chargedhex/magnetic-encoder-sao-supercon-2026/3d-prints/Supercon 2026 Encoder SAO 3D Prints-Knob Base.step

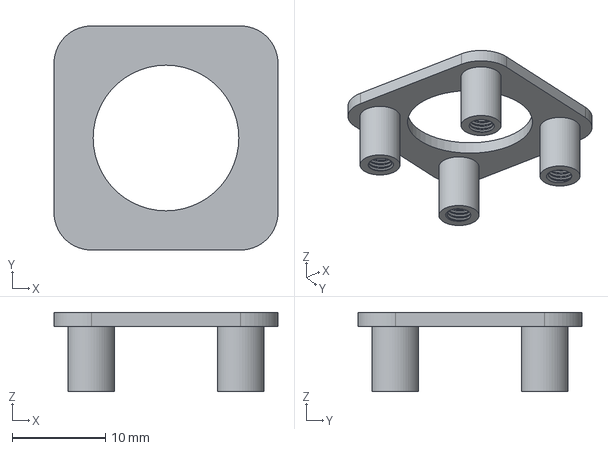
[picture p1: CAD file, 2026-11-10]
3d-prints/Supercon 2026 Encoder SAO 3D Prints-Knob Base.step
24.0 x 24.0 x 8.50 mm
