chargedhex/magnetic-encoder-sao-supercon-2026/3d-prints/Supercon 2026 Encoder SAO 3D Prints-Knob Top.step

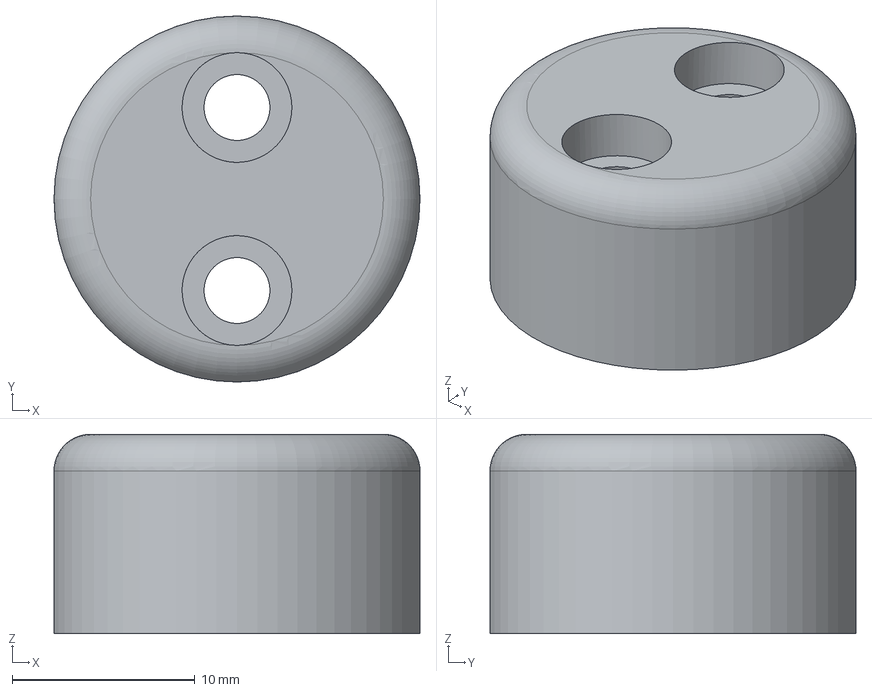
[picture p2: CAD file, 2026-11-10]
3d-prints/Supercon 2026 Encoder SAO 3D Prints-Knob Top.step
20.0 x 20.0 x 10.9 mm
