chargedhex/magnetic-encoder-sao-supercon-2026/3d-prints/Supercon 2026 Encoder SAO 3D Prints-Knob Base 3.step

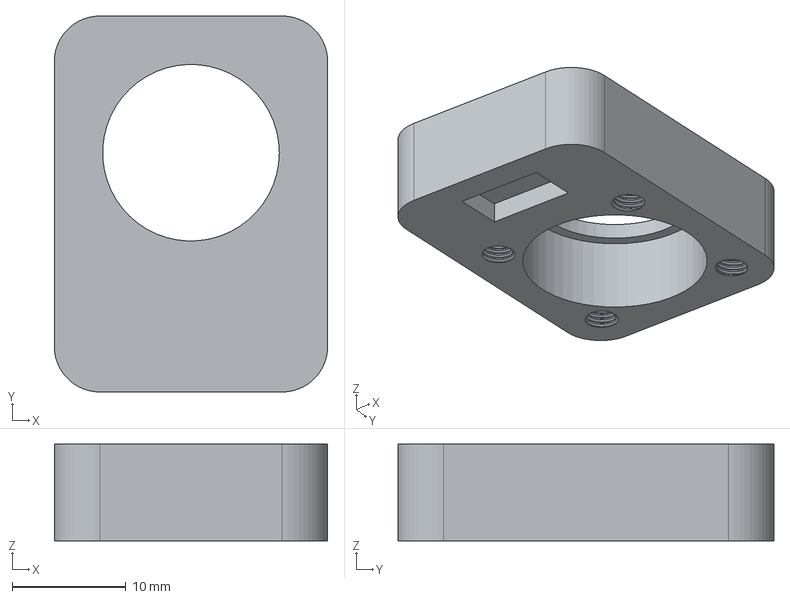
[picture p3: CAD file, 2026-11-10]
3d-prints/Supercon 2026 Encoder SAO 3D Prints-Knob Base 3.step
24.0 x 33.0 x 8.50 mm
