chargedhex/magnetic-encoder-sao-supercon-2026/3d-prints/Supercon 2026 Encoder SAO 3D Prints-Knob Top 2.step

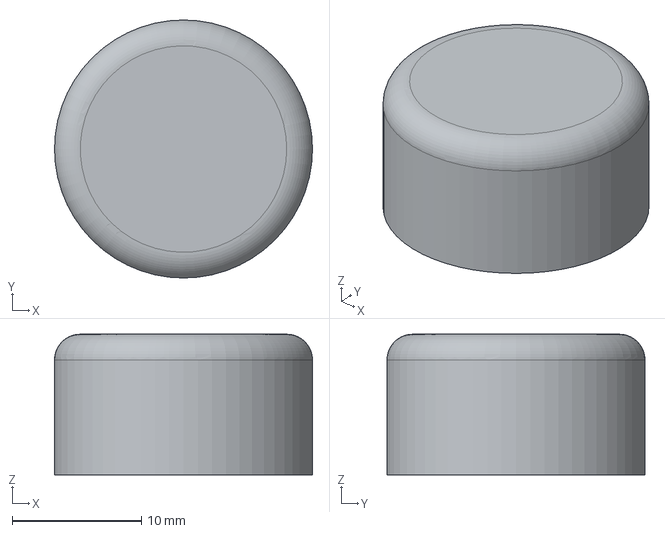
[picture p5: CAD file, 2026-11-10]
3d-prints/Supercon 2026 Encoder SAO 3D Prints-Knob Top 2.step
20.0 x 20.0 x 10.9 mm
