chargedhex/magnetic-encoder-sao-supercon-2026/3d-prints/Supercon 2026 Encoder SAO 3D Prints.FCStd

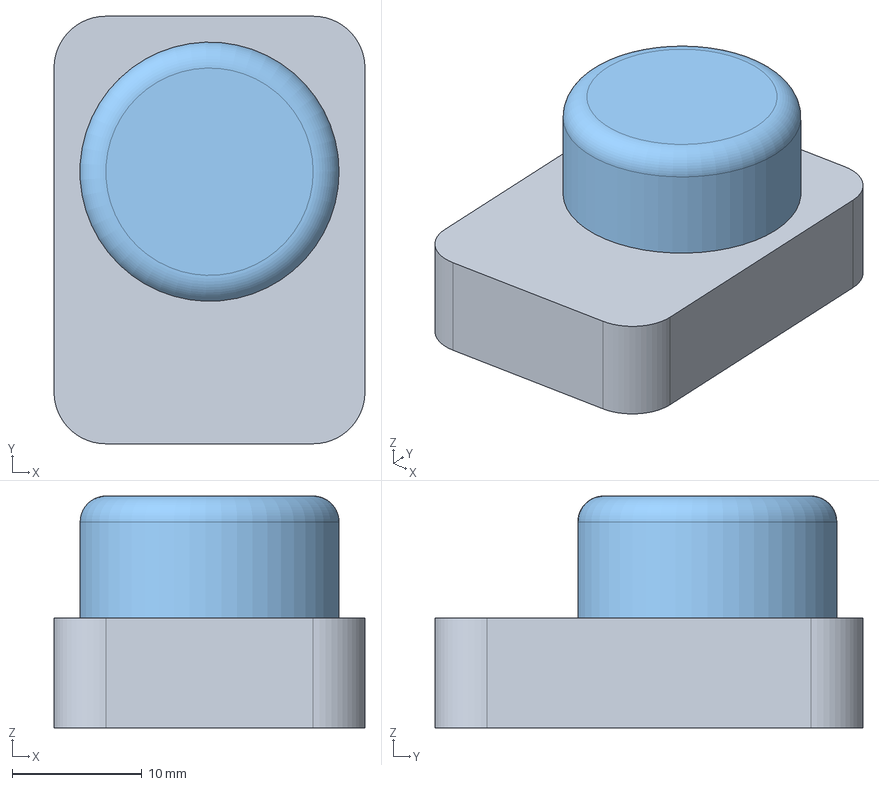
[picture p8: CAD file, 2026-11-06]
3d-prints/Supercon 2026 Encoder SAO 3D Prints.FCStd
24.0 x 33.0 x 17.9 mm
Knob Base 3
Knob Shaft 2
Knob Top 2
