chargedhex/magnetic-encoder-sao-supercon-2026/hardware/encoder_sao_connector_supercon_2026.kicad_pcb

## KiCad design hardware/encoder_sao_connector_supercon_2026.kicad_pcb (2026-11-06)

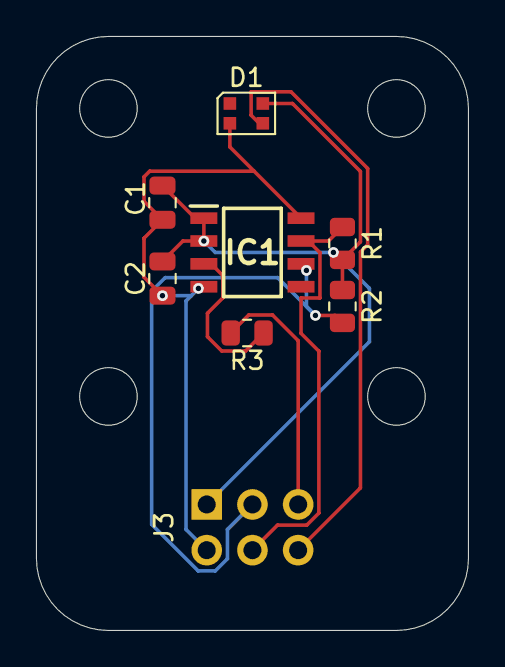
[picture p9: board encoder_sao_connector_supercon_2026.kicad_pcb from above]

Board: 2 copper layers, 24.0 x 33.0 mm, 8 parts (1 on the bottom side), 7 nets.

Parts:
C1: 100nF; C_0805_2012Metric
C2: 1uF; C_0805_2012Metric
D1: WS2812B-2020; LED_WS2812B-2020_PLCC4_2.0x2.0mm
IC1: AS5600-ASOT
J3: Conn_02x03_Odd_Even; PinHeader_2x03_P2.54mm_Vertical
R1, R2: 4.7k; R_0805_2012Metric
R3: 330; R_0805_2012Metric

Connections:
+3V3: C1.1, C2.1, D1.4 (VDD), IC1.1 (VDD5V), IC1.2 (VDD3V3), J3.1, R1.2, R2.1
GND: C1.2, C2.2, D1.2 (VSS), IC1.4 (GND), IC1.8 (DIR), J3.2
encoder_analog_out: IC1.3 (OUT), R3.2
encoder_i2c_scl: IC1.7 (SCL), J3.4, R1.1
encoder_i2c_sda: IC1.6 (SDA), J3.3, R2.2
neopixel_data: D1.3 (DIN), J3.6
resistor_analog_out: J3.5, R3.1
