chargedhex/magnetic-encoder-sao-supercon-2026/3d-prints/README.md

# Magnetic Encoder 3D Files
These 3d prints are required for the magnetic encoder to have something to read. There are a few different types of base, shaft, and top. All the bases are compatible with all of the shaft and top types, but the knob shaft and knob top types need to match. Knob Top is only compatible with Knob Shaft, and Knob Top 2 is only compatible with Knob Shaft 2, but Knob Base, Knob Base 2, and Knob Base 3 are compatible with both sets of tops and shafts.

I have included the .FDStd file (open with FreeCAD to edit) where they are all instantiated. For ease of 3d printing, I have also provided all the components as individual .step files.

Knob Shaft 2 is shaped as it is to make support removal a bit easier for 3d printing, but wave overhangs also work well with its current geometry.

## Knob Base
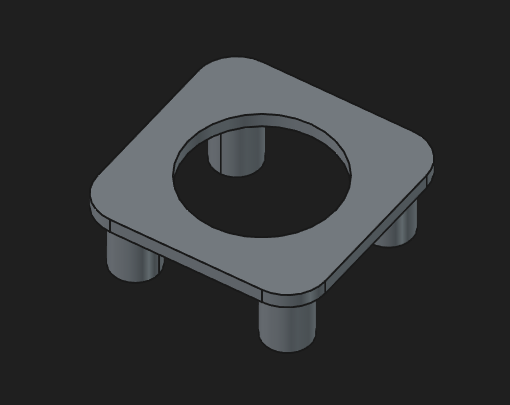
[picture p10: 3d-prints/images/Knob_Base.png]
Knob_Base Knob Base Photo


## Knob Base 2
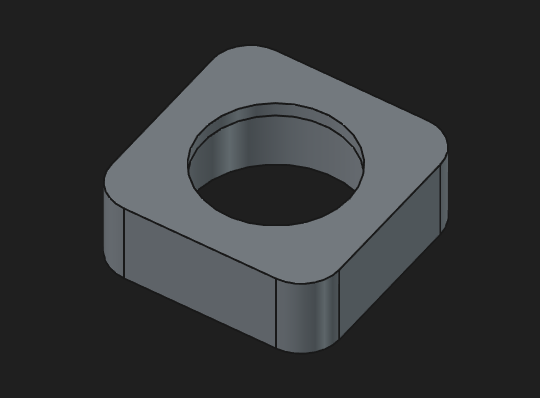
[picture p11: 3d-prints/images/Knob_Base_2.png]
Knob_Base_2 Knob Base 2 Photo


## Knob Base 3
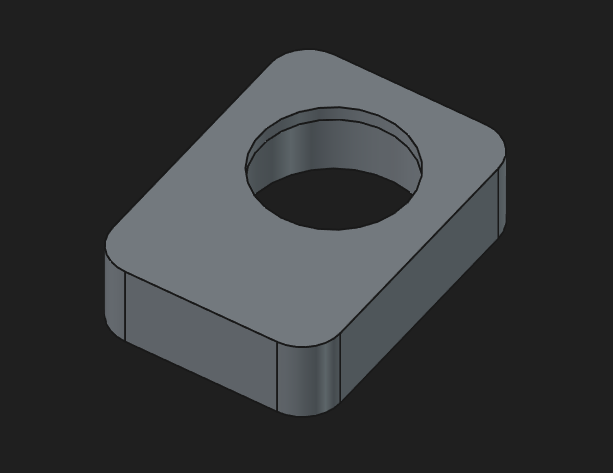
[picture p12: 3d-prints/images/Knob_Base_3.png]
Knob_Base_3 Knob Base 3 Photo


## Knob Top
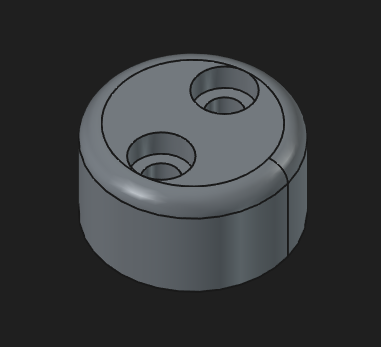
[picture p13: 3d-prints/images/Knob_Top.png]
Knob_Top Knob Top Photo


## Knob Shaft
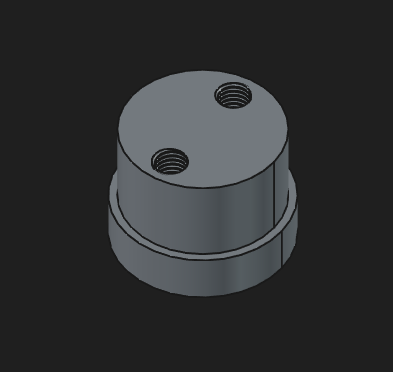
[picture p14: 3d-prints/images/Knob_Shaft.png]
Knob_Shaft Knob Shaft Photo


## Knob Top 2
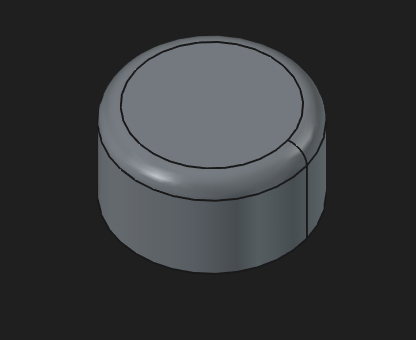
[picture p15: 3d-prints/images/Knob_Top_2.png]
Knob_Top_2 Knob Top 2 Photo


## Knob Shaft 2
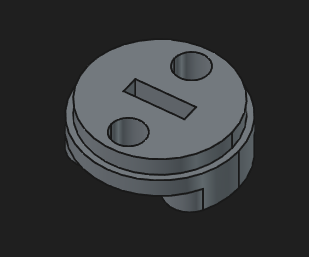
[picture p16: 3d-prints/images/Knob_Shaft_2.png]
Knob_Shaft_2 Knob Shaft 2 Photo
