chargedhex/magnetic-encoder-sao-supercon-2026/(commit log)

2026-11-06 adding the PCB to the hardware directory
    [encoder_sao_connector_supercon_2026-B_Cu.gbr, encoder_sao_connector_supercon_2026-B_Mask.gbr, encoder_sao_connector_supercon_2026-B_Paste.gbr, encoder_sao_connector_supercon_2026-B_Silkscreen.gbr, encoder_sao_connector_supercon_2026-Edge_Cuts.gbr, encoder_sao_connector_supercon_2026-F_Cu.gbr, encoder_sao_connector_supercon_2026-F_Mask.gbr, encoder_sao_connector_supercon_2026-F_Paste.gbr]
2026-11-06 adding the 3d prints for the magnetic encoder SAO and updated the README with information on additional components that are needed
    [Supercon 2026 Encoder SAO 3D Prints.FCStd]
2026-11-10 added .step files for all the 3d printed parts, added images for the 3d printed parts and completed SAOs, and added some additional information in the 3d-prints/README.md and README.md
    [Supercon 2026 Encoder SAO 3D Prints-Knob Base 2.step, Supercon 2026 Encoder SAO 3D Prints-Knob Base 3.step, Supercon 2026 Encoder SAO 3D Prints-Knob Base.step, Supercon 2026 Encoder SAO 3D Prints-Knob Shaft 2.step, Supercon 2026 Encoder SAO 3D Prints-Knob Shaft.step, Supercon 2026 Encoder SAO 3D Prints-Knob Top 2.step, Supercon 2026 Encoder SAO 3D Prints-Knob Top.step]
